AvaotaSBC/Avaota-A1/hardware/v1.7/04_BOM/BOM_Avaota Pi A_PCB1_2024-08-17.xlsx

No. | Device | Name | Designator | Value | Footprint | Manufacturer | Manufacturer Part | Supplier | Supplier Part | Quantity | JLCPCB Price | Pins | Primary Category | Secondary Category | Comment
1 | 1N5819WS_C191023 | 1N5819WS | D32 |  | SOD-323_L1.8-W1.3-LS2.5-RD | Hottech(合科泰) | 1N5819WS | LCSC | C191023 | 1 | 0.0511 | 0 | 二极管 | 肖特基二极管 | 1N5819WS
2 | 1.14 IPS DISPLAY ST7789V |  | TFT1 |  | TFT_1.14寸_0.7MM-13P |  |  |  |  | 1 |  | 0 |  |  | 1.14 IPS DISPLAY ST7789V
3 | 7D025000Q01 | 25MHz | X3 | 25MHz | crystal-smd_4p-l2.0-w1.6-bl-nsk | HD(浩都频率) | 7D025000Q01 | LCSC | C648942 | 1 | 0.57 | 0 | 晶振/振荡器/谐振器 | 无源晶振 | 25MHz
4 | 7D025000Q01 | 25MHz | X4 | 25MHz | crystal-smd_4p-l2.0-w1.6-bl-nsk | HD(浩都频率) | 7D025000Q01 | LCSC |  | 1 |  | 0 | 晶振/振荡器/谐振器 | 无源晶振 | 25MHz
5 | 0201CG220J500NT | 22pF | C98,C99,C100,C101,C251,C252,C257,C259 | 22pF | c0201 nsk | FH(风华) | 0201CG220J500NT | LCSC | C57783 | 8 | 0.00408 | 0 | 电容 | 贴片电容(MLCC) | 22pF
6 | 0201X225M6R3NT | 2.2uF | C13,C14,C19,C20,C21,C22,C23,C24,C35,C36,C37,C38,C39,C40,C41,C45,C46,C47,C48,C49,C50,C51,C52,C53,C54,C55,C57,C58,C59,C60,C61,C62,C63,C64,C65,C66,C67,C68,C69,C71,C73,C75,C76,C77,C78,C83,C84,C85,C86,C116,C117,C132,C134,C142,C143,C147,C161,C225,C228,C231,C234,C249,C250,C253,C256,C258,C260,C276,C277 | 2.2uF | c0201 nsk | FH(风华) | 0201X225M6R3NT | LCSC | C285111 | 69 | 0.0365 | 0 | 电容 | 贴片电容(MLCC) | 2.2uF
7 | 0201X225M6R3NT | 100nF | C254,C261,C262,C263,C264,C265,C266,C267,C268,C269,C270,C271,C272,C273,C274,C275 | 100nF | c0201 nsk | FH(风华) | 0201X225M6R3NT | LCSC |  | 16 |  | 0 | 电容 | 贴片电容(MLCC) | 100nF
8 | 0402ESDA-05N |  | D16,D17,D18,D19,D20,D21,D22,D23 |  | D0402 | BORN(伯恩半导体) | 0402ESDA-05N | LCSC | C316049 | 8 | 0.131 | 0 | TVS/保险丝/板级保护 | 静电和浪涌保护(TVS/ESD) | 0402ESDA-05N
9 | 0402ESDA-05N |  | D24,D25,D26,D27,D30,D31 |  | d0402 | BORN伯恩半导体 | 0402ESDA-05N | LCSC | C316049 | 6 | 0.131 | 0 |  |  | 0402ESDA-05N
10 | 12251220ANG0S115001 | 12251220ANG0S115001 | H1 |  | HDR-TH_40P-P2.54-V-M-R2-C20-S2.54 | JILN(锦凌) | 12251220ANG0S115001 | LCSC | C429965 | 1 | 0.691 | 0 | 连接器 | 排针 | 12251220ANG0S115001
11 | 0533980271 | 0533980271 | CN3,CN4 |  | CONN-SMD_2P-P1.25_053398-0X71 | MOLEX | 0533980271 | LCSC | C122410 | 2 | 0.71 | 0 | 连接器 | 线对板/线对线连接器 | 0533980271
12 | 1040310811 | 1040310811 | SIM1 |  | SIM-SMD_8P-1040310811 | MOLEX | 1040310811 | LCSC | C585350 | 1 | 4.27 | 0 | 连接器 | SD卡连接器 | 1040310811
13 | AXP323 | AXP323 | U5 |  | QFN-20_L3.0-W3.0-P0.40-BL-EP1.5 |  |  |  |  | 1 |  | 0 |  |  | AXP323
14 | AXP717B | AXP717 | U4 |  | QFN-52_L6.0-W6.0-P0.40-BL-EP3.4-1 |  |  |  |  | 1 |  | 0 |  |  | AXP717
15 | B5819WS_C22624 | B5819WS | D1 |  | SOD-323_L1.8-W1.3-LS2.5-RD | CJ(江苏长电/长晶) | B5819WS | LCSC | C22624 | 1 | 0.166 | 0 | 二极管 | 肖特基二极管 | B5819WS
16 | B5819WT_C2997265 | B5819WT | D7,D9 |  | SOD-523_L1.2-W0.8-LS1.6-RD-1 NSK | BORN(伯恩半导体) | B5819WT | LCSC | C2997265 | 2 | 0.136 | 0 | 二极管 | 肖特基二极管 | B5819WT
17 | BWIPX-1-001E | BWIPX-1-001E | RF1 |  | IPEX-SMD_BWIPX-1-001E | BAT WIRELESS(蝙蝠无线) | BWIPX-1-001E | LCSC | C496552 | 1 | 0.366 | 0 | 连接器 | RF射频同轴连接器 | BWIPX-1-001E
18 | CAP_0402 | 2.2uF | C221,C223,C237,C247 | 2.2uF | c0402-nsk |  |  |  |  | 4 |  | 0 |  |  | 2.2uF
19 | CAP_0402 | 10uF | C200 | 10uF | c0402-nsk |  |  |  |  | 1 |  | 0 |  |  | 10uF
20 | CAP_0402 | 22pF | C10 | 22pF | c0402-nsk |  |  |  |  | 1 |  | 0 |  |  | 22pF
21 | CAP_0402 | 100nF | C4,C222,C224,C242,C243,C246,C280 | 100nF | c0402-nsk |  |  |  |  | 7 |  | 0 |  |  | 100nF
22 | CAP_0402 | 2200pF | C9 | 2200pF | c0402-nsk |  |  |  |  | 1 |  | 0 |  |  | 2200pF
23 | CAP_0603 | 22uF | C281,C282 | 22uF | C0603-NSK |  |  |  |  | 2 |  | 0 |  |  | 22uF
24 | CAP_0603 | 100nF | C1,C2,C3,C7,C8 | 100nF | C0603-NSK |  |  |  |  | 5 |  | 0 |  |  | 100nF
25 | CAP_0805 | 47uF | C5,C6 | 47uF | C0805 NSK |  |  |  |  | 2 |  | 0 |  |  | 47uF
26 | CAP_1206 | 10nF/2KV | C248,C255 | 10nF/2KV | C1206 |  |  |  |  | 2 |  | 0 |  |  | 10nF/2KV
27 | CAP_1206 | 22uF | C294 | 22uF | C1206 |  |  |  |  | 1 |  | 0 |  |  | 22uF
28 | CL05A225KP5NSNC | 2.2uF | C56 | 2.2uF | c0402-nsk | SAMSUNG(三星) | CL05A225KP5NSNC | LCSC | C107369 | 1 | 0.0193 | 0 | 电容 | 贴片电容(MLCC) | 2.2uF
29 | CL05A475KP5NRNC | 4.7uF | C70,C79,C82 | 4.7uF | c0402-nsk | SAMSUNG(三星) | CL05A475KP5NRNC | LCSC | C368809 | 3 | 0.0395 | 0 | 电容 | 贴片电容(MLCC) | 4.7uF
30 | CL10A226MP8NUNE | 22uF | C27,C28,C44,C283,C284,C285,C286,C287,C288,C289,C290,C291,C292,C293 | 22uF | C0603-NSK | SAMSUNG(三星) | CL10A226MP8NUNE | LCSC | C86295 | 14 | 0.0812 | 0 | 电容 | 贴片电容(MLCC) | 22uF
31 | DC-044A-A200 | DC-044A-A200 | DC1 |  | DC-IN-TH_DC-044A-20A | XUNPU(讯普) | DC-044A-A200 | LCSC | C720575 | 1 | 1.281 | 0 | 连接器 | AC/DC电源连接器 | DC-044A-A200
32 | DP_TH_SIDE_VERTICAL |  | U15 |  | DP_TH_SIDE_VERTICAL |  |  |  |  | 1 |  | 0 |  |  | DP_TH_SIDE_VERTICAL
33 | EMMC BGA153 |  | U8 |  | FBGA-153_L13.0-W11.5 | Kingston(金士顿) | EMMC04G-M627-A01 | LCSC | C577446 | 1 | 35.1 | 0 |  |  | EMMC04G-M627-A01
34 | FAN2510 |  | FAN |  | FAN2510 |  |  |  |  | 1 |  | 0 |  |  | FAN2510
35 | FPC-05FB-30PH20 | FPC-05FB-30PH20 | FPC2 |  | FPC-SMD_30P-P0.50_FPC-05FB-30PH20 | XUNPU(讯普) | FPC-05FB-30PH20 | LCSC | C2856833 | 1 | 1.0355 | 0 | 连接器 | FFC/FPC连接器 | FPC-05FB-30PH20
36 | FPC-05FB-50PH20 | FPC-05FB-50PH20 | FPC1 |  | FPC-SMD_50P-P0.50_FPC-05FB-50PH20 | XUNPU(讯普) | FPC-05FB-50PH20 | LCSC | C2856838 | 1 | 1.609 | 0 | 连接器 | FFC/FPC连接器 | FPC-05FB-50PH20
37 | FXL0630-4R7-M | 4.7uH | L1 | 4.7uH | IND-SMD_L7.0-W6.6 | cjiang(长江微电) | FXL0630-4R7-M | LCSC | C167220 | 1 | 0.501 | 0 | 电感/线圈/变压器 | 功率电感 | 4.7uH
38 | GRM033R60J104KE19D | 100nF | C11 | 100nF | c0201 nsk | muRata(村田) | GRM033R60J104KE19D | LCSC | C76928 | 1 | 0.00581 | 0 | 电容 | 贴片电容(MLCC) | 100nF
39 | GRM033R61A104KE15D | 1nF | C94,C95,C96,C97,C107 | 1nF | c0201 nsk | muRata(村田) | GRM033R61A104KE15D | LCSC |  | 5 |  | 0 | 电容 | 贴片电容(MLCC) | 1nF
40 | GRM033R61A104KE15D | 2.2uF | C103,C104,C105,C108,C113,C114,C115,C163,C165,C167,C169,C171,C173,C175,C177,C179,C181,C183,C185,C187,C201,C202,C204,C208,C210,C214,C215 | 2.2uF | c0201 nsk | muRata(村田) | GRM033R61A104KE15D | LCSC |  | 27 |  | 0 | 电容 | 贴片电容(MLCC) | 2.2uF
41 | GRM033R61A104KE15D | 10nF | C106 | 10nF | c0201 nsk | muRata(村田) | GRM033R61A104KE15D | LCSC |  | 1 |  | 0 | 电容 | 贴片电容(MLCC) | 10nF
42 | GRM033R61A104KE15D | 33pF | C239 | 33pF | c0201 nsk | muRata(村田) | GRM033R61A104KE15D | LCSC |  | 1 |  | 0 | 电容 | 贴片电容(MLCC) | 33pF
43 | GRM033R61A104KE15D | 100nF | C90,C91,C92,C93,C102,C118,C119,C120,C121,C122,C123,C124,C125,C126,C127,C128,C129,C130,C131,C133,C135,C136,C137,C138,C139,C140,C141,C144,C145,C146,C148,C149,C150,C151,C152,C153,C154,C155,C156,C157,C158,C159,C160,C162,C189,C190,C191,C192,C193,C194,C195,C196,C197,C198,C199,C216,C219,C220,C226,C227,C229,C230,C232,C233,C235,C236,C238,C241 | 100nF | c0201 nsk | muRata(村田) | GRM033R61A104KE15D | LCSC | C76934 | 68 | 0.00567 | 0 | 电容 | 贴片电容(MLCC) | 100nF
44 | GRM033R61A104KE15D | 100nF | C164,C166,C168,C170,C172,C174,C176,C178,C180,C182,C184,C186,C188,C209,C211,C213,C218,C240 | 100nF | c0201 nsk | muRata(村田) | GRM033R61A104KE15D | LCSC |  | 18 |  | 0 | 电容 | 贴片电容(MLCC) | 100nF
45 | GRM033R61A104KE15D | 470nF | C109,C110,C111,C112 | 470nF | c0201 nsk | muRata(村田) | GRM033R61A104KE15D | LCSC |  | 4 |  | 0 | 电容 | 贴片电容(MLCC) | 470nF
46 | GRM033R61A104KE15D | NC | C244,C245 | NC | c0201 nsk | muRata(村田) | GRM033R61A104KE15D | LCSC |  | 2 |  | 0 | 电容 | 贴片电容(MLCC) | NC
47 | GRM033R61A105ME44D | 1uF | C12,C17,C30,C43,C88 | 1uF | c0201 nsk | muRata(村田) | GRM033R61A105ME44D | LCSC | C76935 | 5 | 0.0181 | 0 | 电容 | 贴片电容(MLCC) | 1uF
48 | GRM155R60J226ME11D | 22uF | C15,C16,C18,C25,C26,C29,C31,C32,C33,C34,C42,C72,C74,C80,C81,C87,C89 | 22uF | c0402-nsk | muRata(村田) | GRM155R60J226ME11D | LCSC | C415703 | 17 | 0.208 | 0 | 电容 | 贴片电容(MLCC) | 22uF
49 | HDMI-001C_C2836126 | HDMI-001C | USB1 |  | HDMI-SMD_HDMI-001C | XUNPU(讯普) | HDMI-001C | LCSC | C2836126 | 1 | 4.67 | 0 | 连接器 | D-Sub/DVI/HDMI连接器 | HDMI-001C
50 | HR911130A |  | RJ1,RJ2 |  | RJ45-TH_HR911130A | HANRUN(汉仁) | HR911130A | LCSC | C54408 | 2 | 13.74 | 0 |  |  | HR911130A
51 | IRM-H638T/TR2 | IRM-H638T/TR2 | CGQ1 |  | SENSOR-SMD_IRM-H638T-TR2-TL | EVERLIGHT(亿光) | IRM-H638T/TR2 | LCSC | C91447 | 1 | 1.419 | 0 | 光耦/LED/数码管/光电器件 | 红外遥控接收头 | IRM-H638T/TR2
52 | LED_0807-RGB |  | LED1 |  | RGBLED_0807 |  |  |  |  | 1 |  | 0 |  |  | LED_0807-RGB
53 | LPDDR4_FBGA200 |  | UD1 |  | BGA200P65_80B1000_1500H90 |  |  |  |  | 1 |  | 0 |  |  | LPDDR4_FBGA200
54 | PJ-327A0-SMT | PJ-327A0-SMT | CN2 |  | AUDIO-SMD_PJ-327A0-SMT | XKB Connectivity(中国星坤) | PJ-327A0-SMT | LCSC | C381135 | 1 | 0.669 | 0 | 连接器 | 音频连接器 | PJ-327A0-SMT
55 | Q13FC1350000400 | 32.768kHz | X2 | 32.768kHz | osc-smd_l3.2-w1.5 nsk | EPSON(爱普生) | Q13FC1350000400 | LCSC | C32346 | 1 | 1.241 | 0 | 晶振/振荡器/谐振器 | 无源晶振 | 32.768kHz
56 | RClamp0524PATCT_C40960 | RClamp0524PATCT | D5,D6,D8,D10,D11,D12,D13,D14,D15 |  | SLP2510P8_L2.5-W1.0-P0.50-BL | SEMTECH | RClamp0524PATCT | LCSC | C40960 | 9 | 0.462 | 0 | TVS/保险丝/板级保护 | 静电和浪涌保护(TVS/ESD) | RClamp0524PATCT
57 | Res_0201 | 0 | R14,R24,R36,R37,R72,R122 | 0 | r0201 nsk |  |  |  |  | 6 |  | 0 |  |  | 0
58 | Res_0201 | 1K | R21,R22,R23,R26,R27,R49,R54,R55,R59 | 1K | r0201 nsk |  |  |  |  | 9 |  | 0 |  |  | 1K
59 | Res_0201 | 1M | R56,R57 | 1M | r0201 nsk |  |  |  |  | 2 |  | 0 |  |  | 1M
60 | Res_0201 | 1.5K | R83,R101 | 1.5K | r0201 nsk |  |  |  |  | 2 |  | 0 |  |  | 1.5K
61 | Res_0201 | 2K | R64 | 2K | r0201 nsk |  |  |  |  | 1 |  | 0 |  |  | 2K
62 | Res_0201 | 2.49K | R85,R103 | 2.49K | r0201 nsk |  |  |  |  | 2 |  | 0 |  |  | 2.49K
63 | Res_0201 | 3.9K | R33 | 3.9K | r0201 nsk |  |  |  |  | 1 |  | 0 |  |  | 3.9K
64 | Res_0201 | 4K7 | R11,R12,R52,R53 | 4K7 | r0201 nsk |  |  |  |  | 4 |  | 0 |  |  | 4K7
65 | Res_0201 | 4.7K | R82,R86,R88,R89,R90,R91,R92,R93,R94,R95,R96,R100,R104,R106,R107,R108,R109,R110,R111,R112,R113,R114,R127,R128 | 4.7K | r0201 nsk |  |  |  |  | 24 |  | 0 |  |  | 4.7K
66 | Res_0201 | 5K1 | R17 | 5K1 | r0201 nsk |  |  |  |  | 1 |  | 0 |  |  | 5K1
67 | Res_0201 | 5.1K | R129,R130 | 5.1K | r0201 nsk |  |  |  |  | 2 |  | 0 |  |  | 5.1K
68 | Res_0201 | 6K8 | R115,R116,R117 | 6K8 | r0201 nsk |  |  |  |  | 3 |  | 0 |  |  | 6K8
69 | Res_0201 | 10k | R124 | 10k | r0201 nsk |  |  |  |  | 1 |  | 0 |  |  | 10k
70 | Res_0201 | 10K | R9,R10,R13,R19,R20,R30,R32,R34,R47,R60,R63,R65,R66,R69,R70,R73,R74,R75,R76 | 10K | r0201 nsk |  |  |  |  | 19 |  | 0 |  |  | 10K
71 | Res_0201 | 10M | R25 | 10M | r0201 nsk |  |  |  |  | 1 |  | 0 |  |  | 10M
72 | Res_0201 | 22 | R67,R68 | 22 | r0201 nsk |  |  |  |  | 2 |  | 0 |  |  | 22
73 | Res_0201 | 33 | R41,R42,R43,R123,R125 | 33 | r0201 nsk |  |  |  |  | 5 |  | 0 |  |  | 33
74 | Res_0201 | 60 | R77,R78 | 60 | r0201 nsk |  |  |  |  | 2 |  | 0 |  |  | 60
75 | Res_0201 | 100 | R48,R50,R51 | 100 | r0201 nsk |  |  |  |  | 3 |  | 0 |  |  | 100
76 | Res_0201 | 100K | R118,R119,R121 | 100K | r0201 nsk |  |  |  |  | 3 |  | 0 |  |  | 100K
77 | Res_0201 | 120 | R38 | 120 | r0201 nsk |  |  |  |  | 1 |  | 0 |  |  | 120
78 | Res_0201 | 180K | R120 | 180K | r0201 nsk |  |  |  |  | 1 |  | 0 |  |  | 180K
79 | Res_0201 | 200 | R44,R45,R46 | 200 | r0201 nsk |  |  |  |  | 3 |  | 0 |  |  | 200
80 | Res_0201 | 240 | R39,R40 | 240 | r0201 nsk |  |  |  |  | 2 |  | 0 |  |  | 240
81 | Res_0201 | 510 | R79,R80,R97,R98 | 510 | r0201 nsk |  |  |  |  | 4 |  | 0 |  |  | 510
82 | Res_0201 | NC | R31,R35,R61,R62 | NC | r0201 nsk |  |  |  |  | 4 |  | 0 |  |  | NC
83 | Res_0402 | 0 | R28 | 0 | R0402-NSK |  |  |  |  | 1 |  | 0 | 电阻 | 贴片电阻 | 0
84 | Res_0402 | 1.96K | R8 | 1.96K | R0402-NSK |  |  |  |  | 1 |  | 0 | 电阻 | 贴片电阻 | 1.96K
85 | Res_0402 | 10 | R126 | 10 | R0402-NSK |  |  |  |  | 1 |  | 0 | 电阻 | 贴片电阻 | 10
86 | Res_0402 | 10.2K | R5 | 10.2K | R0402-NSK |  |  |  |  | 1 |  | 0 | 电阻 | 贴片电阻 | 10.2K
87 | Res_0402 | 37.4K | R7 | 37.4K | R0402-NSK |  |  |  |  | 1 |  | 0 | 电阻 | 贴片电阻 | 37.4K
88 | Res_0402 | 51.1 | R3 | 51.1 | R0402-NSK |  |  |  |  | 1 |  | 0 | 电阻 | 贴片电阻 | 51.1
89 | Res_0402 | 130K | R6 | 130K | R0402-NSK |  |  |  |  | 1 |  | 0 | 电阻 | 贴片电阻 | 130K
90 | Res_0402 | 665K | R4 | 665K | R0402-NSK |  |  |  |  | 1 |  | 0 | 电阻 | 贴片电阻 | 665K
91 | Res_0603 | 100K | R1,R2 | 100K | R0603 NSK |  |  |  |  | 2 |  | 0 | 电阻 | 贴片电阻 | 100K
92 | RTL8211F-CG | RTL8211F-CG | U12,U13 |  | WQFN-40_L5.0-W5.0-P0.4-BL-EP | REALTEK(瑞昱) | RTL8211F-CG | LCSC | C187932 | 2 | 6.61 | 0 | 通信接口芯片/UART/485/232 | 以太网芯片 | RTL8211F-CG
93 | RVT1H101M0607 | 100uF | U1,U2 | 100uF | CAP-SMD_BD6.3-L6.6-W6.6-LS7.6-RD | ROQANG(容强) | RVT1H101M0607 | LCSC | C3151829 | 2 | 0.378 | 0 | 电容 | 贴片型铝电解电容 | 100uF
94 | SMCJ15CA_C438202 | SMCJ15CA | D2 |  | SMC_L6.9-W5.9-LS7.9-BI | 晶导微电子 | SMCJ15CA | LCSC | C438202 | 1 | 0.567 | 0 | TVS/保险丝/板级保护 | 静电和浪涌保护(TVS/ESD) | SMCJ15CA
95 | SS54_C22452 | SS54 | D3,D4 |  | SMA_L4.4-W2.8-LS5.4-R-RD | MDD | SS54 | LCSC | C22452 | 2 | 0.289 | 0 | 二极管 | 肖特基二极管 | SS54
96 | SY6280AAC_C55136 | SY6280AAC | U16,U17 |  | SOT-23-5_L3.0-W1.7-P0.95-LS2.8-BL | silergy(矽力杰) | SY6280AAC | LCSC | C55136 | 2 | 0.63 | 0 | 电源芯片 | 功率电子开关 | SY6280AAC
97 | T527 |  | U14 |  | T527-BGA664 |  |  |  |  | 1 |  | 0 | Allwinner | SOC | T527
98 | TAXM24M4ZDBCCT2T | 24MHz | X1 | 24MHz | crystal-smd_4p-l2.0-w1.6-bl-nsk | YJX(雅晶鑫) | TAXM24M4ZDBCCT2T | LCSC | C388793 | 1 | 0.504 | 0 | 晶振/振荡器/谐振器 | 无源晶振 | 24MHz
99 | TFM201610ALM-1R0MTAA | 1uH | L2,L3,L4,L5,L6,L7,L8 | 1uH | ind-smd_l2.0-w1.6_1 | TDK | TFM201610ALM-1R0MTAA | LCSC | C598616 | 7 | 0.603 | 0 | 电感/线圈/变压器 | 贴片电感 | 1uH
100 | TJA1051T_C7432801 | TJA1051T | U11 |  | SOP-8_L4.9-W3.9-P1.27-LS6.0-BL | Tokmas(托克马斯) | TJA1051T | LCSC | C7432801 | 1 | 4.71 | 0 | 通信接口芯片/UART/485/232 | CAN芯片 | TJA1051T
101 | TPS54531DDAR | TPS54531DDAR | U3 |  | SOIC-8_L5.0-W4.0-P1.27-LS6.0-BL-EP2.0 | TI(德州仪器) | TPS54531DDAR | LCSC | C50605 | 1 | 2.65 | 0 | 电源芯片 | DC-DC电源芯片 | TPS54531DDAR
102 | TYPEC-304-BCP16 |  | USB3 |  | USB-C-SMD_TYPEC-304-BCP16-1 | XUNPU | TYPEC-304-BCP16 | LCSC | C720629 | 1 | 0.706 | 0 |  |  | TYPEC-304-BCP16
103 | USB-303WSD-BRY | USB-303WSD-BRY | USB2 |  | USB-A-TH_XUNPU_USB-303WSD-BRY | XUNPU(讯普) | USB-303WSD-BRY | LCSC | C2895028 | 1 | 2.57 | 0 | 连接器 | USB连接器 | USB-303WSD-BRY
104 | W25N01GVZEIG_C88868 | W25N01GVZEIG | U18 |  | WSON-8_L8.0-W6.10-P1.27-BL-EP | WINBOND(华邦) | W25N01GVZEIG | LCSC | C88868 | 1 | 6.85 | 0 | 存储器 | NAND FLASH | W25N01GVZEIG
105 | WPN252012H2R2MT | 2.2uH | L9,L10 | 2.2uH | IND-SMD_L2.0-W1.6 | Sunlord(顺络) | WPN252012H2R2MT | LCSC | C98350 | 2 | 0.36 | 0 | 电感/线圈/变压器 | 功率电感 | 2.2uH
106 | WS2812B-2020 | WS2812B-2020 | LED2,LED3,LED4,LED5 |  | LED-SMD_4P-L2.0-W2.0-TL_WS2812B-2020 | worldsemi | WS2812B-2020 | LCSC | C965555 | 4 | 0.477 | 0 | 光耦/LED/数码管/光电器件 | 发光二极管/LED | WS2812B-2020
107 | XR829MQ | AIC8800D | U9 |  | LGA-44_L12.0-W12.0-P0.90 |  | AIC8800D | LCSC | C3039827 | 1 | 0.243 | 0 |  |  | AIC8800D
108 | YJL2305A | YJL2305A | Q1 |  | SOT-23-3_L2.9-W1.3-P1.90-LS2.4-BR | YANGJIE(扬杰) | YJL2305A | LCSC | C699306 | 1 | 0.251 | 0 | 三极管/MOS管/晶体管 | 场效应管(MOSFET) | YJL2305A
109 | YTSA016A0252501B | YTSA016A0252501B | FEL1,PWR1,RESET1 |  | SW-SMD_4P-L4.2-W3.4-P2.15-LS4.5-TL | DGBZ(东莞博众) | YTSA016A0252501B | LCSC | C967791 | 3 | 0.192 | 0 | 按键/开关 | 轻触开关 | YTSA016A0252501B
