AvaotaSBC/Avaota-A1/(threads)

Thread 1 (2024-02-29):

About Wifi and Bluetooth / WifiとBluetoothについて

Yon4800, 2024-02-29:
Hello! Nice to meet you. / こんにちは！初めましてです。
I was really looking forward to this SBC coming out! thank you! / 私はこのSBCが出るのをとても楽しみにしていました！ありがとうございます！
Right away, this one seems to have Wifi and Bluetooth, but unfortunately Wifi and Bluetooth cannot be used in Japan because of the "Technical Compliance" law in Japan. / 早速なんですけど、こちらはWifi、Bluetoothがついているようですが、日本では「技適」という法律があるので日本では残念ながらWifi、Bluetoothが使えません。
Therefore, I would like you to either pass the technical standards so that it can be used in Japan, or disable Wifi and Bluetooth, or release a version that does not have Wifi and Bluetooth. / そのため、日本でも使えるように技適をとっていただくか、もしくはWifi、Bluetoothが使えないようにするか、Wifi、Bluetoothがないバージョンを出してほしいと思っています。
It may be an unreasonable request, but is it possible? / 無理な要求かもしれませんが、可能でしょうか？
I would really appreciate it if you could do it. / 本当にできればでいいのでお願いいたします
Sorry for Google translation. / Google翻訳で申し訳ないです。
I'm sorry if this isn't what I'm talking about here. Change location. / ここで話すことでなかったら申し訳ないです。場所を変えます。

YuzukiTsuru, 2024-02-29:
もちろんです！Wi-Fiモジュールのないバージョンを購入することができます！

Yon4800, 2024-02-29:
Thank you! / ありがとうございます！

Closed 2024-02-29.

Thread 2 (2024-05-10):

購入先と電源端子について / About where to buy and power terminal

Yon4800, 2024-05-10:
こんにちは！
また申し訳ないです。

早速ですが一つ目の質問です。
Avaota A1の購入をそのうち検討してみようかなと考えているのですが、Aliexpressを見たところ、販売元であるDongshanPIの商品が表示できない、店舗名が表示されなくなってしまっている(shopXXXXのように表示されている)のですが、Avaota A1を購入した方のようなものをX(Twitter)で見つけましたが、まだAliexpressでは購入できないのでしょうか？

もう一つの質問は、Avaota A1の電源DCの端子(差す場所)のサイズの表記がないようですが、このサイズはどのくらいが適切でしょうか？もうすでに書いていたら申し訳ないです。

回答をお待ちしております。m(_ _)m

<br>
Hello!
I'm sorry again.

First question right away. ,
I'm thinking about purchasing Avaota A1 soon, but when I checked Aliexpress, I found that I couldn't display products from the seller, DongshanPI, and the store name was no longer displayed (like shopXXXX). However, I found someone on X (Twitter) who bought Avaota A1, but is it still not available for purchase on Aliexpress?

Another question is that there doesn't seem to be any indication of the size of the Avaota A1's power supply DC terminal (where it is plugged in), so what is the appropriate size? I apologize if this has already been written.

I look forward to your answer. m(_ _)m

<hr>

こんな感じになっています / It looks like this.
↓
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

YuzukiTsuru, 2024-05-10:
現在、販売プラットフォームはまだありませんが、後で100askまたはPine64を通じて購入できます。電源には12v2AのDC電源を使用できます。

Yon4800, 2024-05-10:
わかりました。
ありがとうございます。
後大変申し訳ございませんが、電源の端子のサイズというのは12V2Aなどの電力量(この表現で合ってるかわかりませんが)ではなくて、DCジャックの丸型端子の外径、内径のことです。
表現が悪くて申し訳ないです

YuzukiTsuru, 2024-05-12:
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

Yon4800, 2024-05-12:
ありがとうございます

Closed 2024-05-12.

Thread 3 (2024-06-25):

GPIO 和 50FPC 排线 的针脚定义

upsangel, 2024-06-25:
你好，
感谢团队设计和生成此款开发板
请问GPIO 和 50FPC 的针脚定义 在哪里可以查到？
我只能在 https://github.com/AvaotaSBC/Avaota-A1/blob/master/hardware/v1.4/01_SCH/SCH_Avaota%20Pi%20A_2024-05-20.pdf 倒数第二页猜到这是针脚的定义，可以给出更加清晰的指引吗？就像树莓派、香橙派之类都会列出每个针脚的顺序和调试。
现阶段的目标是想适配合适的触摸屏，
谢谢！

SamulKyull, 2024-08-05:
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

upsangel, 2024-08-05:
Thank you!

Closed 2024-08-05.

Thread 4 (2024-08-05):

Looking for Manufacturing Details

aldwinhermanudin, 2024-08-05:
Hi,

First of all, thank you for creating an open-source SBC design! This is really awesome, and I will definitely helps others a lot!
I'm currently trying to manufacture the SBC myself so I can start tinkering with the design. but I have couple of questions below,

- There are missing `Supplier Part` for some of the discrete components, like the capacitors. Are there a required specifications for those? for example, can I choose any  `tolerance`, and ` temperature coefficient` for the capacitor?
- Where can I find the stack-up information for the board, such as `layer thickness` and layer `Dielectric constant (Dk)` ?

Thank you!

aldwinhermanudin, 2024-08-06:
Thank you!

Closed 2024-08-06.

Thread 5 (2024-08-05):

Android - Root is not enabled?

upsangel, 2024-08-05:
Flashed with t527_android13_avaota_a1_uart0_eng.zip	, adb with USB no problem, network adb can be enabled no problem.
But ROOT is not enabled in this image? Is there a root image with root, or how to enable root in t527_android13_avaota_a1_uart0_eng ?
Thank you!

YuzukiTsuru, 2024-08-05:
Yes

upsangel, 2024-08-06:
> Yes

Thank you for your reply.

I saw on your official page: https://docs.avaota.fun/android/build/build

t527_avaota_a1_arm64-eng：开发版，开放串口控制台，**ROOT等**。内核适配时使用。

But I flashed the t527_android13_avaota_a1_uart0_eng.zip (https://pan.baidu.com/s/1HMWV-rDZNWTkFrdo7tcsWg?pwd=avat) it has no root.

Would you mind sharing the link for an img with 开发版，开放串口控制台，**ROOT等** available to download?

Thank you!

SamulKyull, 2024-08-20:
https://docs.avaota.fun/android/develop/root

thanhtantran, 2025-02-15:
I don't have baidu account to download android, can anyone upload to google drive  please?

kiramint, 2025-05-26:
> I don't have baidu account to download android, can anyone upload to google drive please?

# VERSION V1.0 2024-05-12

https://docs.avaota.fun/android/intro/os-download/

* Google Drive:

https://drive.google.com/drive/folders/1YeETOa5ot2Mqtaewnu21enkNiNQ0x86e?usp=sharing

> You should unzip before calculating the md5

Closed 2024-12-01.
