AvaotaSBC/Avaota-A1/hardware/v1.4/01_SCH/SCH_Avaota Pi A_2024-05-20.pdf

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
LCD; OSC; DEBUGAUDIO; GPIO; WIFI; GPHY; CAM

22

55

TITLE: | REV:

Date:

Sheet:
Drawn By:
Company: YuzukiHD | Total:
2024-04-25 | GloomyGhost

Avaota A1 八核 AIoT 开发板

# LPDDR4

# eMMC

# GPIO

# MIPI

DP

# HDMI

# USB30

# Card

# GPIO



GND GND

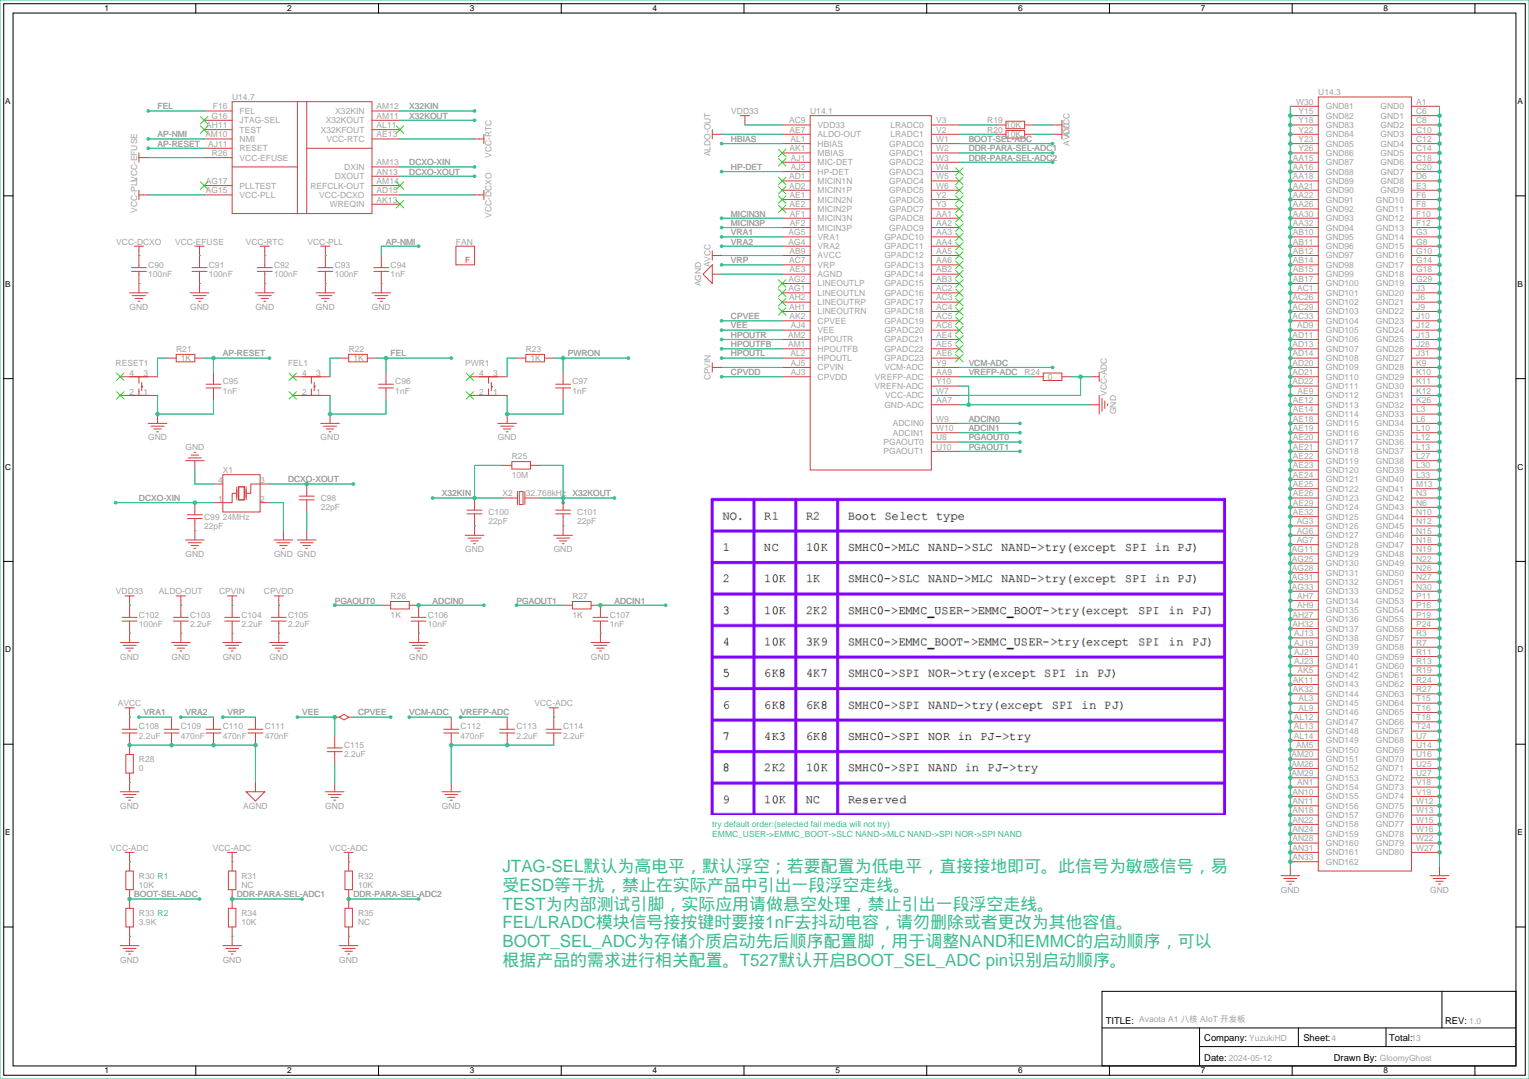
[picture p38: page 4]

VCC-EFUSE VCC-PLL

VCM-ADC VREFP-ADC

try default order:(selected fail media will not try)
EMMC_USER->EMMC_BOOT->SLC NAND->MLC NAND->SPI NOR->SPI NAND

JTAG-SEL默认为高电平，默认浮空；若要配置为低电平，直接接地即可。此信号为敏感信号，易
受ESD等干扰，禁止在实际产品中引出一段浮空走线。
TEST为内部测试引脚，实际应用请做悬空处理，禁止引出一段浮空走线。
FEL/LRADC模块信号接按键时要接1nF去抖动电容，请勿删除或者更改为其他容值。
BOOT_SEL_ADC为存储介质启动先后顺序配置脚，用于调整NAND和EMMC的启动顺序，可以
根据产品的需求进行相关配置。T527默认开启BOOT_SEL_ADC pin识别启动顺序。

CA5_B P11 CA4_B R11 CA3_B R10 CA2_B R9 CA1_B P2 CA0_B R2 CA5_A J11 CA4_A H11 CA3_A H10 CA2_A H9 CA1_A J2 CA0_A H2


T527支持DDR3/3L、DDR4、LPDDR3、LPDDR4、LPDDR4x，使用时需先确定DRAM的类型、片选及位宽
DRAM上电时序请严格参照标案原理图设计。LPDDR3、LPDDR4、LPDDR4x颗粒需要的VDD18-LPDDR电源使用BLDO2供电；
DDR4颗粒需要的VCC25-DRAM电源需外挂LDO供电，
使用AXP717B BLDO2使能控制输出；LPDDR4x颗粒需要的VCC-DRAML电源需外挂DCDC供电，使用AXP717B BLDO2使能控制输出。
DRAM外部分立器件的数量、值大小以及精度不允许随意更改，请严格参照标案原理图设计。
DRAM所有的滤波电容不能删减，预留的滤波电容建议在开发阶段预留调试，但可以不贴片，待开发测试验证稳定之后，量产可以根据实际情况酌情删除

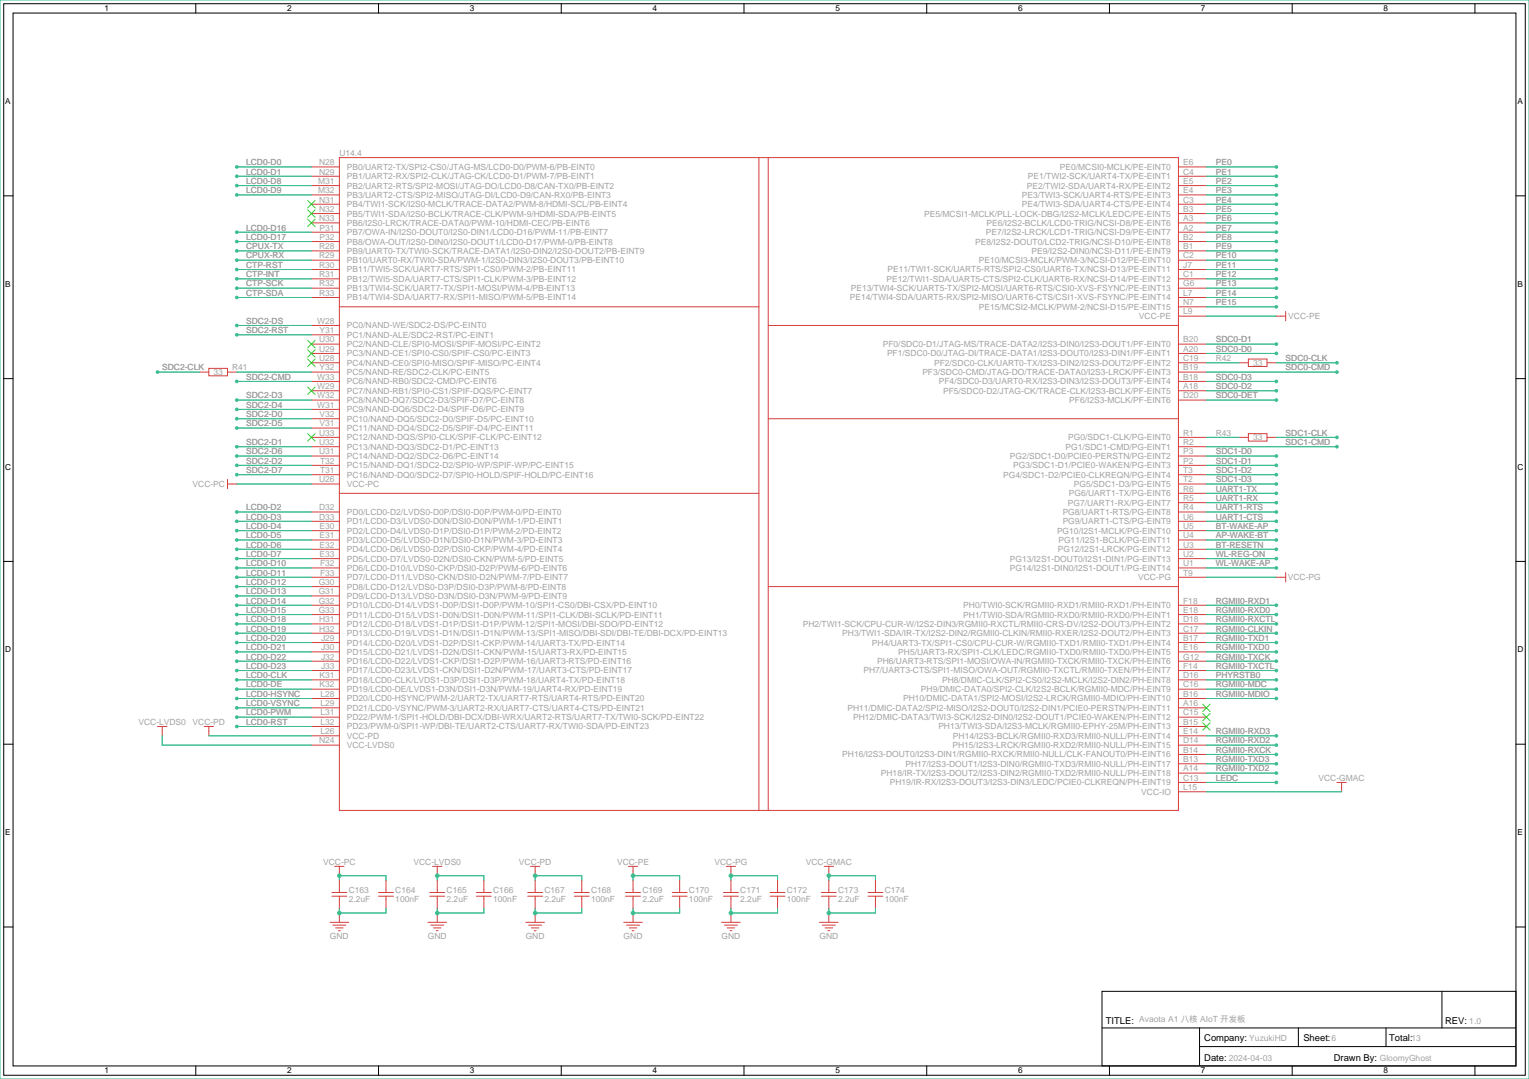
[picture p39: page 6]

PB0/UART2-TX/SPI2-CS0/JTAG-MS/LCD0-D0/PWM-6/PB-EINT0 N28
PB1/UART2-RX/SPI2-CLK/JTAG-CK/LCD0-D1/PWM-7/PB-EINT1 N29
PB2/UART2-RTS/SPI2-MOSI/JTAG-DO/LCD0-D8/CAN-TX0/PB-EINT2 M31
PB3/UART2-CTS/SPI2-MISO/JTAG-DI/LCD0-D9/CAN-RX0/PB-EINT3 M32
PB4/TWI1-SCK/I2S0-MCLK/TRACE-DATA2/PWM-8/HDMI-SCL/PB-EINT4 N31
PB5/TWI1-SDA/I2S0-BCLK/TRACE-CLK/PWM-9/HDMI-SDA/PB-EINT5 N32
PB6/I2S0-LRCK/TRACE-DATA0/PWM-10/HDMI-CEC/PB-EINT6 N33
PB7/OWA-IN/I2S0-DOUT0/I2S0-DIN1/LCD0-D16/PWM-11/PB-EINT7 P31
PB8/OWA-OUT/I2S0-DIN0/I2S0-DOUT1/LCD0-D17/PWM-0/PB-EINT8 P32
PB9/UART0-TX/TWI0-SCK/TRACE-DATA1/I2S0-DIN2/I2S0-DOUT2/PB-EINT9 R28
PB10/UART0-RX/TWI0-SDA/PWM-1/I2S0-DIN3/I2S0-DOUT3/PB-EINT10 R29
PB11/TWI5-SCK/UART7-RTS/SPI1-CS0/PWM-2/PB-EINT11 R30
PB12/TWI5-SDA/UART7-CTS/SPI1-CLK/PWM-3/PB-EINT12 R31
PB13/TWI4-SCK/UART7-TX/SPI1-MOSI/PWM-4/PB-EINT13 R32
PB14/TWI4-SDA/UART7-RX/SPI1-MISO/PWM-5/PB-EINT14 R33

PE5/MCSI1-MCLK/PLL-LOCK-DBG/I2S2-MCLK/LEDC/PE-EINT5 B3

PE6/I2S2-BCLK/LCD0-TRIG/NCSI-D8/PE-EINT6 A3
PE7/I2S2-LRCK/LCD1-TRIG/NCSI-D9/PE-EINT7 A2
PE8/I2S2-DOUT0/LCD2-TRIG/NCSI-D10/PE-EINT8 B2
PE10/MCSI3-MCLK/PWM-3/NCSI-D12/PE-EINT10 C2

PE11/TWI1-SCK/UART5-RTS/SPI2-CS0/UART6-TX/NCSI-D13/PE-EINT11 J7
PE12/TWI1-SDA/UART5-CTS/SPI2-CLK/UART6-RX/NCSI-D14/PE-EINT12 C1

PE13/TWI4-SCK/UART5-TX/SPI2-MOSI/UART6-RTS/CSI0-XVS-FSYNC/PE-EINT13 G6
PE14/TWI4-SDA/UART5-RX/SPI2-MISO/UART6-CTS/CSI1-XVS-FSYNC/PE-EINT14 L7

PE15/MCSI2-MCLK/PWM-2/NCSI-D15/PE-EINT15 N7

PC0/NAND-WE/SDC2-DS/PC-EINT0 W28
PC1/NAND-ALE/SDC2-RST/PC-EINT1 Y31
PC2/NAND-CLE/SPI0-MOSI/SPIF-MOSI/PC-EINT2 U30
PC3/NAND-CE1/SPI0-CS0/SPIF-CS0/PC-EINT3 U29
PC4/NAND-CE0/SPI0-MISO/SPIF-MISO/PC-EINT4 U28
PC5/NAND-RE/SDC2-CLK/PC-EINT5 Y32
PC6/NAND-RB0/SDC2-CMD/PC-EINT6 W33
PC7/NAND-RB1/SPI0-CS1/SPIF-DQS/PC-EINT7 W29
PC8/NAND-DQ7/SDC2-D3/SPIF-D7/PC-EINT8 W32
PC9/NAND-DQ6/SDC2-D4/SPIF-D6/PC-EINT9 W31
PC10/NAND-DQ5/SDC2-D0/SPIF-D5/PC-EINT10 V32
PC11/NAND-DQ4/SDC2-D5/SPIF-D4/PC-EINT11 V31
PC12/NAND-DQS/SPI0-CLK/SPIF-CLK/PC-EINT12 U33
PC13/NAND-DQ3/SDC2-D1/PC-EINT13 U32
PC14/NAND-DQ2/SDC2-D6/PC-EINT14 U31
PC15/NAND-DQ1/SDC2-D2/SPI0-WP/SPIF-WP/PC-EINT15 T32
PC16/NAND-DQ0/SDC2-D7/SPI0-HOLD/SPIF-HOLD/PC-EINT16 T31
VCC-PC U26

PF0/SDC0-D1/JTAG-MS/TRACE-DATA2/I2S3-DIN0/I2S3-DOUT1/PF-EINT0 B20
PF1/SDC0-D0/JTAG-DI/TRACE-DATA1/I2S3-DOUT0/I2S3-DIN1/PF-EINT1 A20

PF2/SDC0-CLK/UART0-TX/I2S3-DIN2/I2S3-DOUT2/PF-EINT2 C19
PF3/SDC0-CMD/JTAG-DO/TRACE-DATA0/I2S3-LRCK/PF-EINT3 B19
PF4/SDC0-D3/UART0-RX/I2S3-DIN3/I2S3-DOUT3/PF-EINT4 B18
PF5/SDC0-D2/JTAG-CK/TRACE-CLK/I2S3-BCLK/PF-EINT5 A18

PD0/LCD0-D2/LVDS0-D0P/DSI0-D0P/PWM-0/PD-EINT0 D32
PD1/LCD0-D3/LVDS0-D0N/DSI0-D0N/PWM-1/PD-EINT1 D33
PD2/LCD0-D4/LVDS0-D1P/DSI0-D1P/PWM-2/PD-EINT2 E30
PD3/LCD0-D5/LVDS0-D1N/DSI0-D1N/PWM-3/PD-EINT3 E31
PD4/LCD0-D6/LVDS0-D2P/DSI0-CKP/PWM-4/PD-EINT4 E32
PD5/LCD0-D7/LVDS0-D2N/DSI0-CKN/PWM-5/PD-EINT5 E33
PD6/LCD0-D10/LVDS0-CKP/DSI0-D2P/PWM-6/PD-EINT6 F32
PD7/LCD0-D11/LVDS0-CKN/DSI0-D2N/PWM-7/PD-EINT7 F33
PD8/LCD0-D12/LVDS0-D3P/DSI0-D3P/PWM-8/PD-EINT8 G30
PD9/LCD0-D13/LVDS0-D3N/DSI0-D3N/PWM-9/PD-EINT9 G31
PD10/LCD0-D14/LVDS1-D0P/DSI1-D0P/PWM-10/SPI1-CS0/DBI-CSX/PD-EINT10 G32
PD11/LCD0-D15/LVDS1-D0N/DSI1-D0N/PWM-11/SPI1-CLK/DBI-SCLK/PD-EINT11 G33
PD12/LCD0-D18/LVDS1-D1P/DSI1-D1P/PWM-12/SPI1-MOSI/DBI-SDO/PD-EINT12 H31
PD13/LCD0-D19/LVDS1-D1N/DSI1-D1N/PWM-13/SPI1-MISO/DBI-SDI/DBI-TE/DBI-DCX/PD-EINT13 H32
PD14/LCD0-D20/LVDS1-D2P/DSI1-CKP/PWM-14/UART3-TX/PD-EINT14 J29
PD15/LCD0-D21/LVDS1-D2N/DSI1-CKN/PWM-15/UART3-RX/PD-EINT15 J30
PD16/LCD0-D22/LVDS1-CKP/DSI1-D2P/PWM-16/UART3-RTS/PD-EINT16 J32
PD17/LCD0-D23/LVDS1-CKN/DSI1-D2N/PWM-17/UART3-CTS/PD-EINT17 J33
PD18/LCD0-CLK/LVDS1-D3P/DSI1-D3P/PWM-18/UART4-TX/PD-EINT18 K31
PD19/LCD0-DE/LVDS1-D3N/DSI1-D3N/PWM-19/UART4-RX/PD-EINT19 K32
PD20/LCD0-HSYNC/PWM-2/UART2-TX/UART7-RTS/UART4-RTS/PD-EINT20 L28
PD21/LCD0-VSYNC/PWM-3/UART2-RX/UART7-CTS/UART4-CTS/PD-EINT21 L29
PD22/PWM-1/SPI1-HOLD/DBI-DCX/DBI-WRX/UART2-RTS/UART7-TX/TWI0-SCK/PD-EINT22 L31
PD23/PWM-0/SPI1-WP/DBI-TE/UART2-CTS/UART7-RX/TWI0-SDA/PD-EINT23 L32
VCC-PD L26
VCC-LVDS0 N24

PH2/TWI1-SCK/CPU-CUR-W/I2S2-DIN3/RGMII0-RXCTL/RMII0-CRS-DV/I2S2-DOUT3/PH-EINT2 D18

PH3/TWI1-SDA/IR-TX/I2S2-DIN2/RGMII0-CLKIN/RMII0-RXER/I2S2-DOUT2/PH-EINT3 C17
PH4/UART3-TX/SPI1-CS0/CPU-CUR-W/RGMII0-TXD1/RMII0-TXD1/PH-EINT4 B17
PH5/UART3-RX/SPI1-CLK/LEDC/RGMII0-TXD0/RMII0-TXD0/PH-EINT5 E16
PH6/UART3-RTS/SPI1-MOSI/OWA-IN/RGMII0-TXCK/RMII0-TXCK/PH-EINT6 G12
PH7/UART3-CTS/SPI1-MISO/OWA-OUT/RGMII0-TXCTL/RMII0-TXEN/PH-EINT7 F14

PH8/DMIC-CLK/SPI2-CS0/I2S2-MCLK/I2S2-DIN2/PH-EINT8 D16
PH9/DMIC-DATA0/SPI2-CLK/I2S2-BCLK/RGMII0-MDC/PH-EINT9 C16
PH10/DMIC-DATA1/SPI2-MOSI/I2S2-LRCK/RGMII0-MDIO/PH-EINT10 B16

PH11/DMIC-DATA2/SPI2-MISO/I2S2-DOUT0/I2S2-DIN1/PCIE0-PERSTN/PH-EINT11 A16
PH12/DMIC-DATA3/TWI3-SCK/I2S2-DIN0/I2S2-DOUT1/PCIE0-WAKEN/PH-EINT12 C15

PH13/TWI3-SDA/I2S3-MCLK/RGMII0-EPHY-25M/PH-EINT13 B15
PH14/I2S3-BCLK/RGMII0-RXD3/RMII0-NULL/PH-EINT14 E14
PH15/I2S3-LRCK/RGMII0-RXD2/RMII0-NULL/PH-EINT15 D14

PH16/I2S3-DOUT0/I2S3-DIN1/RGMII0-RXCK/RMII0-NULL/CLK-FANOUT0/PH-EINT16 B14

PH17/I2S3-DOUT1/I2S3-DIN0/RGMII0-TXD3/RMII0-NULL/PH-EINT17 B13
PH18/IR-TX/I2S3-DOUT2/I2S3-DIN2/RGMII0-TXD2/RMII0-NULL/PH-EINT18 A14
PH19/IR-RX/I2S3-DOUT3/I2S3-DIN3/LEDC/PCIE0-CLKREQN/PH-EINT19 C13


PI0/TWI4-SCK/UART4-TX/PWM-1/I2S2-DIN3/I2S2-DOUT3/PI-EINT0 AH13
PI1/TWI4-SDA/UART4-RX/PWM-2/I2S2-DIN2/I2S2-DOUT2/PI-EINT1 AG13
PI2/UART5-TX/SPI1-CS0/PWM-3/I2S2-BCLK/PI-EINT2 AL15
PI3/UART5-RX/SPI1-CLK/PWM-4/I2S2-LRCK/PI-EINT3 AN15
PI4/UART5-RTS/SPI1-MOSI/PWM-5/I2S2-DOUT0/I2S2-DIN1/PI-EINT4 AM15
PI5/UART5-CTS/SPI1-MISO/PWM-6/I2S2-DIN0/I2S2-DOUT1/PI-EINT5 AJ15
PI6/UART6-TX/UART4-RTS/PWM-7/SPI2-CS0/PI-EINT6 AK15
PI7/UART6-RX/UART4-CTS/PWM-8/SPI2-CLK/PI-EINT7 AH15
PI8/TWI5-SCK/IR-RX/PWM-9/SPI2-MOSI/PI-EINT8 AL16
PI9/TWI5-SDA/DMIC-DATA2/PWM-10/PI-EINT9 AM16
PI10/OWA-OUT/DMIC-DATA1/PWM-11/I2S2-MCLK/PI-EINT10 AN17
PI11/UART3-TX/DMIC-DATA0/PWM-12/PI-EINT11 AM17
PI12/UART3-RX/PWM-13/SPI2-MISO/PI-EINT12 AL17
PI13/UART6-CTS/DMIC-DATA3/PWM-14/I2S2-MCLK/PI-EINT13 AK17
PI14/UART6-RTS/DMIC-CLK/PWM-15/PI-EINT14 AM18
PI15/UART3-RTS/TWI2-SCK/PWM-16/CAN-TX0/PI-EINT15 AH17
PI16/UART3-CTS/TWI2-SDA/PWM-17/CAN-RX0/PI-EINT16 AJ17
VCC-PI AE16

PK4/MCSIA-CKN/TWI2-SCK/PK-EINT4 A10
PK5/MCSIA-CKP/TWI2-SDA/PK-EINT5 B10

PK10/MCSIB-CKN/TWI3-SCK/PK-EINT10 E8
PK11/MCSIB-CKP/TWI3-SDA/PK-EINT11 D8

PK12/MCSIC-D0N/UART7-TX/TWI4-SCK/NCSI-PCLK/PK-EINT12 B9
PK13/MCSIC-D0P/UART7-RX/TWI4-SDA/NCSI-MCLK/PK-EINT13 C9
PK14/MCSIC-D1N/UART7-RTS/UART5-RTS/NCSI-HSYNC/PK-EINT14 A8
PK15/MCSIC-D1P/UART7-CTS/UART5-CTS/NCSI-VSYNC/PK-EINT15 B8
PK16/MCSIC-CKN/TWI5-SCK/UART5-TX/NCSI-D0/PK-EINT16 B7
PK17/MCSIC-CKP/TWI5-SDA/UART5-RX/NCSI-D1/PK-EINT17 C7
PK18/MCSID-D0N/MCSI0-MCLK/UART6-TX/NCSI-D2/PK-EINT18 A6
PK19/MCSID-D0P/TWI2-SCK/UART6-RX/NCSI-D3/PK-EINT19 B6
PK20/MCSID-D1N/TWI2-SDA/UART6-RTS/NCSI-D4/PK-EINT20 A5
PK21/MCSID-D1P/MCSI1-MCLK/UART6-CTS/NCSI-D5/PK-EINT21 B5
PK22/MCSID-CKN/TWI3-SCK/PWM-6/NCSI-D6/PK-EINT22 A4
PK23/MCSID-CKP/TWI3-SDA/PWM-7/NCSI-D7/PK-EINT23 B4

PJ0/LCD1-D0/LVDS2-D0P/RGMII1-RXD1/RMII1-RXD1/PJ-EINT0 D1
PJ1/LCD1-D1/LVDS2-D0N/RGMII1-RXD0/RMII1-RXD0/PJ-EINT1 D2
PJ2/LCD1-D2/LVDS2-D1P/RGMII1-RXCTL/RMII1-CRS-DV/PJ-EINT2 E1
PJ3/LCD1-D3/LVDS2-D1N/RGMII1-CLKIN/RMII1-RXER/PJ-EINT3 E2
PJ4/LCD1-D4/LVDS2-D2P/RGMII1-TXD1/RMII1-TXD1/PJ-EINT4 F1
PJ5/LCD1-D5/LVDS2-D2N/RGMII1-TXD0/RMII1-TXD0/PJ-EINT5 F2
PJ6/LCD1-D6/LVDS2-CKP/RGMII1-TXCK/RMII1-TXCK/PJ-EINT6 G1
PJ7/LCD1-D7/LVDS2-CKN/RGMII1-TXCTL/RMII1-TXEN/PJ-EINT7 G2
PJ8/LCD1-D8/LVDS2-D3P/RGMII1-MDC/PJ-EINT8 H2
PJ9/LCD1-D9/LVDS2-D3N/RGMII1-MDIO/PJ-EINT9 H3
PJ10/LCD1-D10/LVDS3-D0P/RGMII1-EPHY-25M/PJ-EINT10 G4
PJ11/LCD1-D11/LVDS3-D0N/RGMII1-RXD3/RMII1-NULL/PJ-EINT11 G5
PJ12/LCD1-D12/LVDS3-D1P/RGMII1-RXD2/RMII1-NULL/PJ-EINT12 J4
PJ13/LCD1-D13/LVDS3-D1N/RGMII1-RXCK/RMII1-NULL/PJ-EINT13 J5
PJ14/LCD1-D14/LVDS3-D2P/RGMII1-TXD3/RMII1-NULL/PJ-EINT14 L4
PJ15/LCD1-D15/LVDS3-D2N/RGMII1-TXD2/RMII1-NULL/PJ-EINT15 L5
PJ16/LCD1-D16/LVDS3-CKP/PJ-EINT16 J1
PJ17/LCD1-D17/LVDS3-CKN/PJ-EINT17 J2
PJ18/LCD1-D18/LVDS3-D3P/PJ-EINT18 N4
PJ19/LCD1-D19/LVDS3-D3N/PJ-EINT19 N5
PJ20/LCD1-D20/UART2-TX/UART3-RTS/SPI0-CS0/PJ-EINT20 K3
PJ21/LCD1-D21/UART2-RX/UART3-CTS/SPI0-CLK/PJ-EINT21 K2
PJ22/LCD1-D22/UART2-RTS/UART3-TX/SPI0-MOSI/PJ-EINT22 L2
PJ23/LCD1-D23/UART2-CTS/UART3-RX/SPI0-MISO/PJ-EINT23 L1
PJ24/LCD1-CLK/TWI4-SCK/UART4-TX/SPI0-CS1/PJ-EINT24 M3
PJ25/LCD1-DE/TWI4-SDA/UART4-RX/SPI0-WP/PJ-EINT25 M2
PJ26/LCD1-HSYNC/TWI5-SCK/UART4-RTS/SPI0-HOLD/PJ-EINT26 N2
PJ27/LCD1-VSYNC/TWI5-SDA/UART4-CTS/PJ-EINT27 N1
VCC-PJ P9
VCC-LVDS1 N9

PL2/S-UART0-TX/S-UART1-TX/S-PWM-2/S-PL-EINT2 AN7
PL3/S-UART0-RX/S-UART1-RX/S-PWM-3/S-PL-EINT3 AM6

PL4/S-JTAG-MS/S-CAN-TX0/S-PWM-4/I2S0-BCLK/S-PL-EINT4 AM7

PL5/S-JTAG-CK/S-CAN-RX0/S-PWM-5/I2S0-LRCK/DMIC-DATA3/S-PL-EINT5 AL7
PL6/S-JTAG-DO/S-PWM-6/I2S0-DIN1/I2S0-DOUT0/DMIC-DATA2/S-PL-EINT6 AN8
PL7/S-JTAG-DI/S-PWM-7/I2S0-DOUT1/I2S0-DIN0/DMIC-DATA1/S-PL-EINT7 AM8
PL8/S-TWI1-SCK/S-DJTAG-MS/S-RJTAG-MS/I2S0-MCLK/DMIC-DATA0/S-PL-EINT8 AN9
PL9/S-TWI1-SDA/S-DJTAG-CK/S-RJTAG-CK/S-PWM-1/DMIC-CLK/S-PL-EINT9 AM9
PL10/S-PWM-0/S-DJTAG-DO/S-RJTAG-DO/DMIC-DATA0/S-SPI0-CS0/S-PL-EINT10 AK9
PL11/S-IR-RX/S-DJTAG-DI/S-RJTAG-DI/DMIC-DATA1/S-SPI0-CLK/S-PL-EINT11 AJ9
PL12/S-TWI2-SCK/S-PWM-8/S-UART0-TX/DMIC-DATA2/S-SPI0-MOSI/S-PL-EINT12 AK7
PL13/S-TWI2-SDA/S-PWM-9/S-UART0-RX/DMIC-DATA3/S-SPI0-MISO/S-PL-EINT13 AJ7

PM0/S-UART0-TX/S-UART1-TX/S-PWM-2/S-PM-EINT0 AN3
PM1/S-UART0-RX/S-UART1-RX/S-PWM-3/S-PM-EINT1 AN2
PM2/S-TWI1-SCK/S-RJTAG-MS/S-PWM-6/S-PM-EINT2 AM4
PM3/S-TWI1-SDA/S-RJTAG-CK/S-PWM-7/S-PM-EINT3 AM3
PM4/S-PWM-8/S-RJTAG-DO/S-TWI2-SCK/S-PM-EINT4 AN4
PM5/S-IR-RX/S-RJTAG-DI/S-TWI2-SDA/S-PWM-9/S-PM-EINT5 AL5

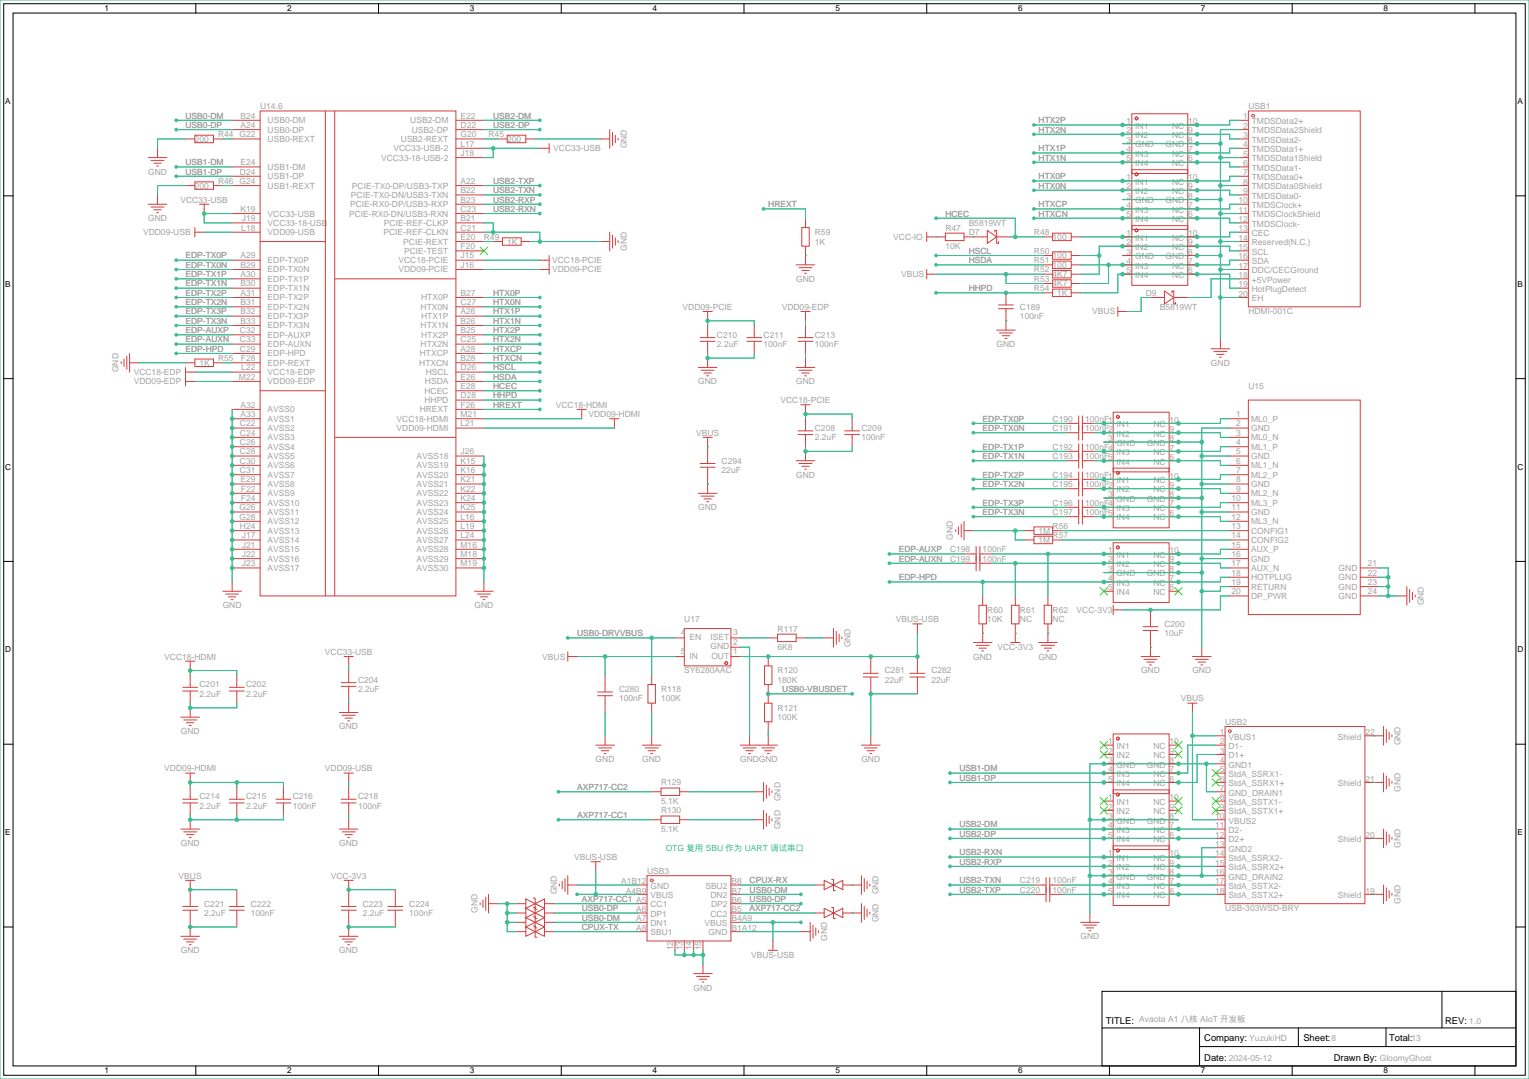
[picture p40: page 8]

# DAT0 A3 DAT1 A4 DAT2 A5 DAT3 B2 DAT4 B3 DAT5 B4 DAT6 B5 DAT7 B6

# FPC1 FPC⁻⁰⁵FB⁻⁵⁰PH²⁰

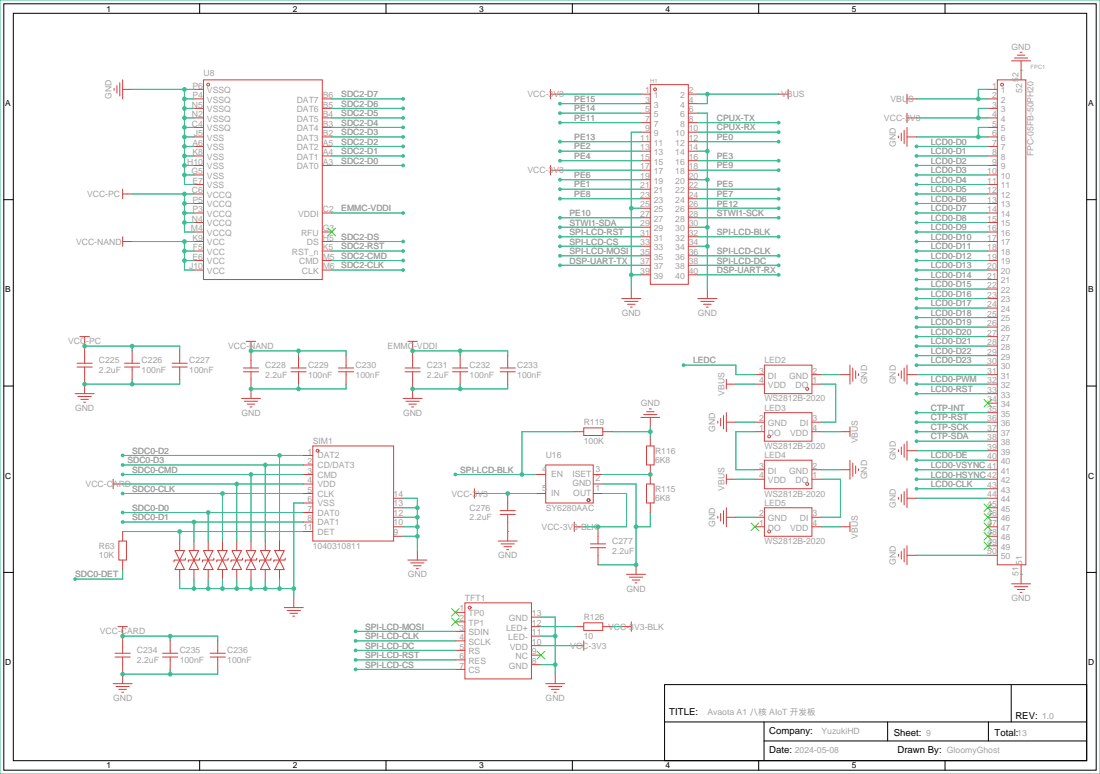
[picture p41: page 9]

GND GND

VDDI C2
CLK M6 CMD M5 RST_n K5 DS H5 RFU G3

VDD 10 LED- 11 LED+ 12 GND 13


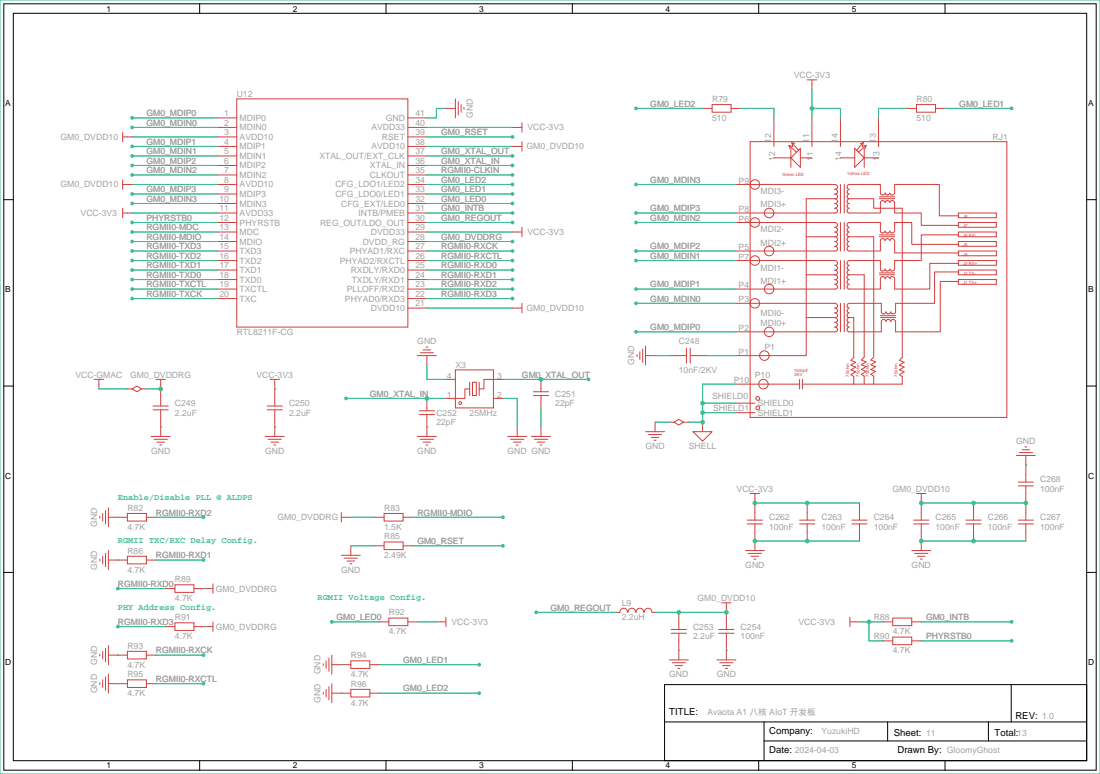
[picture p42: page 11]



GND GND
