AvaotaSBC/Avaota-A1/(list of files, drawings)

Other design files:
hardware/v1.3/02_PCB/ProDocument_PCB1_2024-04-06.epro
hardware/v1.4/02_PCB/ProDoc_PCB1_2024-05-20.epro
hardware/v1.6/02_PCB/ProDoc_PCB1_2024-08-17.epro
hardware/v1.6/08_JLCEDA/ProDoc_Avaota Pi A_2024-08-17.epro
hardware/v1.7/02_PCB/ProDoc_PCB1_3_2024-08-30.epro
hardware/v1.7/08_JLCEDA/ProDoc_Avaota Pi A_1.7_2024-08-30.epro
resource/dram_4l/02_PCB/ProDoc_PCB2_2024-06-06.epro
resource/dram_4l/03_EDA/ProDoc_T527 LPDDR4 4层 模板_2024-06-06.epro
resource/dram_8l/02_PCB/ProDoc_PCB7_2024-06-06.epro
resource/dram_8l/03_EDA/ProDoc_T527 LPDDR4 8层 模板（内存转正）_2024-06-06.epro
