AvaotaSBC/Avaota-A1/(commit log)

2024-06-06 1.4 update
    [BOM_Avaota Pi A_PCB1_2024-03-25.xlsx, BOM_Avaota Pi A_PCB1_2024-04-06.xlsx, BOM_Avaota Pi A_PCB1_2024-05-20.xlsx, PickAndPlace_PCB1_2024-04-06.xlsx, PickAndPlace_PCB1_2024-05-20.xlsx, ProDoc_PCB1_2024-05-20.epro, ProDoc_PCB2_2024-06-06.epro, ProDoc_PCB7_2024-06-06.epro]
2024-08-17 add update v1.6
    [BOM_Avaota Pi A_PCB1_2024-08-17.xlsx, PickAndPlace_PCB1_2024-08-17.xlsx, ProDoc_Avaota Pi A_2024-08-17.epro, ProDoc_PCB1_2024-08-17.epro]
2024-08-30 add v1.7
    [BOM_Avaota Pi A_PCB1_2024-08-17.xlsx, PickAndPlace_PCB1_2024-08-17.xlsx, ProDoc_Avaota Pi A_1.7_2024-08-30.epro, ProDoc_PCB1_3_2024-08-30.epro]
